GKevinLi/mouse/README.md

# Mouse: A custom wireless Bluetooth mouse




There is no cool name for it. I'm not good at naming things.

This is a wireless-capable Bluetooth mouse made entirely using custom parts. Everything required to make it is open source, and the files for each part are in their respective folders.
The only parts of this mouse that aren't custom are the battery and the various PCB attached components (switches, encoder, etc). 

This design can be used with any mouse switch, as long as it has dimensions of 12.8 x 5.8 x 6.5, and any 11mm mouse encoder. 6x6x7.3 silent switches theoretically should be able to work on this design as well, albeit with a few CAD modifications.

For more information on specific parts of the project, refer to the folder-specific READMEs in the cad, firmware, and pcb folders.\
CAD Readme: [Link](<https://github.com/GKevinLi/mouse/blob/main/cad/README.md>)\
Firmware Readme:  [Link](<https://github.com/GKevinLi/mouse/blob/main/firmware/README.md>)\
PCBs Readme:  [Link](<https://github.com/GKevinLi/mouse/blob/main/pcb/README.md>)

## Features

- PMW3610 Mouse Sensor
- nRF52833 Microcontroller
- Can be used when plugged in or on battery power
- Battery charging circuit
- Custom scroll wheel and mouse case
- 2 configurable side buttons

## Bill of Materials

| Item Name | Qty | Price (total) (USD) | Item link | Notes |
| --- | --- | --- | --- | --- |
| Mouse PCB, fully assembled | 2 | $150.05 | [Link](<https://jlcpcb.com/>) | this is how much it cost me for 5 PCBs, 2 fully assembled. Prices may vary. |
| PMW3610 | 1 | $1.09 | [Link](<https://www.aliexpress.us/item/3256809533648177.html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>) | this price is with the aliexpress welcome deal |
| Mouse Switch | 5 | $3.95 | [Link](<https://www.digikey.com/en/products/detail/aratas-formerly-omron-components-/D2FC-F-7N(60M)/20484328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>) | Any 12.8x5.8x6.5 mouse switch works, you can buy them or take them off old mice |
| 11mm Mouse Encoder | 1 | $9.39 | [Link](<https://www.amazon.com/dp/B07HCFMQ3X?plpRedirect=mhFallback&ref=clp_hp_h_pc>) | Any 11mm mouse encoder works, you can buy them or take them off old mice |
| 602535 Battery | 1 | $7.99 | [Link](<https://www.amazon.com/dp/B0GWCRMPSY?plpRedirect=mhFallback&ref=clp_hp_h_pc>) | Any 602535 battery works here. |
| **Total Price (USD)** | | **$172.47** | | |

To build the mouse fully, you will need a soldering iron (and some soldering experience), an SWD debugger, and access to a 3D printer. The links given in the BOM are just recommendations. The battery is optional and the mouse can be used via USB power without it.

## Building tips / Notes:
- This project is currently in a very early stage of development, so building this is not recommended at this time. Only try to build this yourself if you REALLY know what you are doing. It is possible that your project may not work due to some oversight I haven't found yet.
- I am a very busy college student so updates on this may be slow.
- There are probably many issues with this design that I have not discovered yet. Documented issues will be in the folder-specific READMEs.
- The current board design has several major issues. These will have to either be fixed in KiCad or by modifying the assembled board. A corrected version of the design will be made.... eventually, but for now I have documented the issues in the PCB folder's readme file.
- The current mouse case does not have side buttons. These will be added later as well.
- The current mouse case does not support mouse skates.
- To build this, you will have to order your own boards from JLCPCB or another PCB manufacturer. Instructions for this will not be provided at the moment, since the board design has issues anyway. If you have enough experience to fix them then you probably have enough experience to order the boards by yourself as well.
- There is currently not a lot of documentation on this project. This is just a fun personal project of mine at the moment, and I do not have that much time to consistently work on it. I will update this in the future, though.
- THIS IS NOT (currently) A GOOD MOUSE. Do not expect this project, in its current form, to be better than whatever mouse you personally own.

## Credits:
https://github.com/badjeff/leylabella for CAD references

https://github.com/siderakb/pmw3610-pcb for a PMW3610 schematic reference

https://github.com/wareya/DIY-Gaming-Mouse for PCB design and CAD references

KiCanvas PCB Link Here:
