GKevinLi/mouse/mouse_bom_2.csv

Item Name | Qty | Price (total) (USD) | Item link | Notes
Mouse PCB, fully assembled | 2 | $150.05 | https://jlcpcb.com/ | this is how much it cost me for 5 PCBs, 2 fully assembled. Prices may vary.
PMW3610 | 1 | $1.09 | https://www.aliexpress.us/item/3256809533648177.html?curPageLogUid=guoUMjTe3YSZ | this price is with the aliexpress welcome deal
Mouse Switch | 5 | $3.95 | https://www.digikey.com/en/products/detail/aratas-formerly-omron-components-/D2FC-F-7N(60M)/20484328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 | Any 12.8x5.8x6.5 mouse switch works, you can buy them or take them off old mice
11mm Mouse Encoder | 1 | $9.39 | https://www.amazon.com/dp/B07HCFMQ3X?plpRedirect=mhFallback&ref=clp_hp_h_pc | Any 11mm mouse encoder works, you can buy them or take them off old mice
602535 Battery | 1 | $7.99 | https://www.amazon.com/dp/B0GWCRMPSY?plpRedirect=mhFallback&ref=clp_hp_h_pc | Any 602535 battery works here.
Total Price (USD): | $172.47
