GKevinLi/mouse/pcb/production/bom.csv

Designator | Footprint | Quantity | Value | LCSC Part #
C1, C3 | 0402 | 2 | 10nf
C10, C16, C25, C26, C30, C31, C8, C9 | 0402 | 8 | 1uf
C11, C12, C19, C27, C28, C4, C5, C6 | 0402 | 8 | 100nf
C13, C14, C15 | 0603 | 3 | 4.7uf
C17 | 0402 | 1 | 47nf
C18 | 0402 | 1 | 820pf
C2, C33, C34 | 0603 | 3 | 10uf
C20 | 0402 | 1 | 100pf
C21 | 0402 | 1 | 1pf
C22 | 0402 | 1 | 1.2pf
C23, C24 | 0402 | 2 | 12pf
C32 | 0402 | 1 | 2.2uf
C7 | 0402 | 1 | 3.3uf
D4, D5 | 0603 | 2 | LED
IC2 | SOT8 | 1 | LM66200DRLR
J1 | USB_C_Receptacle_HCTL_HC-TYPE-C-16P-01A | 1 | USB_C_Receptacle_USB2.0_14P
J3 | JST_EH_B2B-EH-A_1x02_P2.50mm_Vertical | 1 | Screw_Terminal_01x02
L1 | 0603 | 1 | 10uH
L2 | 0402 | 1 | 15nH
L3 | 0402 | 1 | 4.7nH
L4 | 0402 | 1 | 2.2nH
Q1 | SOT95P280X145-6N | 1 | FS8205
R1, R29, R8 | 0402 | 3 | 10k
R10, R4, R9 | 0402 | 3 | 1k
R11 | 0402 | 1 | 5.1k
R3 | 0402 | 1 | 100
R5, R6 | 0402 | 2 | 5k1
SW1, SW2, SW4, SW6, SW7 | MOYUS SWITCXH | 5 | SW_SPDT_312
SW3 | MOUS WHEL | 1 | RotaryEncoder
SW5 | SW_JS102011JCQN | 1 | SW_SPDT
SW8 | SW_Push_SPST_NO_Alps_SKRK | 1 | SW_Push
TP1, TP10, TP11, TP12, TP13, TP14, TP2, TP3, TP4, TP5, TP6, TP7, TP8, TP9, VMAIN | TestPoint_Pad_D1.0mm | 15 | TestPoint
U1 | PMW3610DM-SUDU 16Pin | 1 | PMW3610
U2 | WSON-6-1EP_2x2mm_P0.65mm_EP1x1.6mm_ThermalVias | 1 | TLV76718DRVx
U4 | SOT-666 | 1 | USBLC6-2P6
U5 | SOT-23-6 | 1 | DW01A
U6 | SOIC-8-1EP_3.9x4.9mm_P1.27mm_EP2.41x3.3mm_ThermalVias | 1 | TP4056-42-ESOP8
U7 | SOT-23-3 | 1 | XC6206PxxxMR
U8 | QFN-40-1EP_5x5mm_P0.4mm_EP3.6x3.6mm | 1 | nRF52833_QDxx
Y2 | Crystal_SMD_2016-4Pin_2.0x1.6mm | 1 | Crystal_GND24
