GKevinLi/mouse/pcb/mous.step

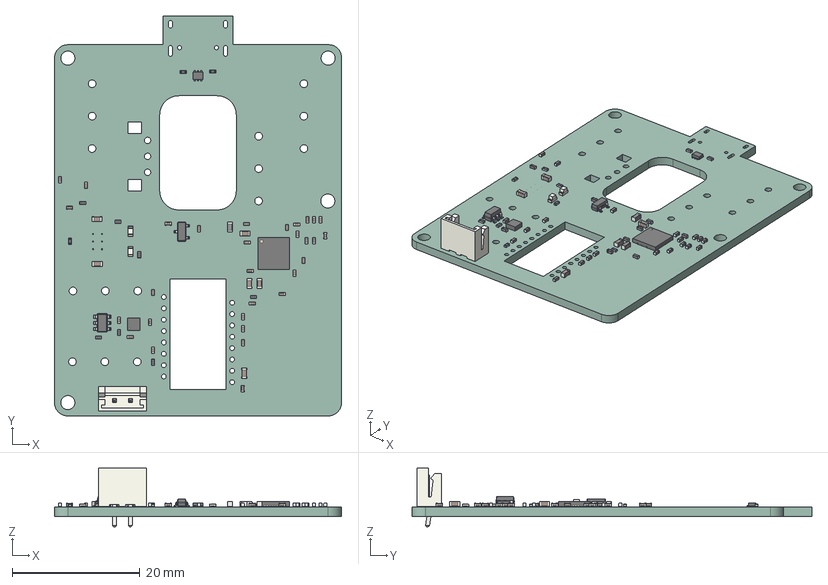
[picture p1: CAD file, 2026-10-29]
pcb/mous.step
45.0 x 62.7 x 9.20 mm
SOT-23-3
C_0402_1005Metric x 27
L_0603_1608Metric
LED_0603_1608Metric x 2
L_0402_1005Metric x 3
JST_EH_B2B-EH-A_1x02_P2.50mm_Vertical
R_0402_1005Metric x 10
C_0603_1608Metric x 6
WSON-6-1EP_2x2mm_P0.65mm_EP1x1.6mm
SOT-23-6
QFN-40-1EP_5x5mm_P0.4mm_EP3.6x3.6mm
SOT-666
mous_PCB
