GKevinLi/mouse/cad/mouse_top.step

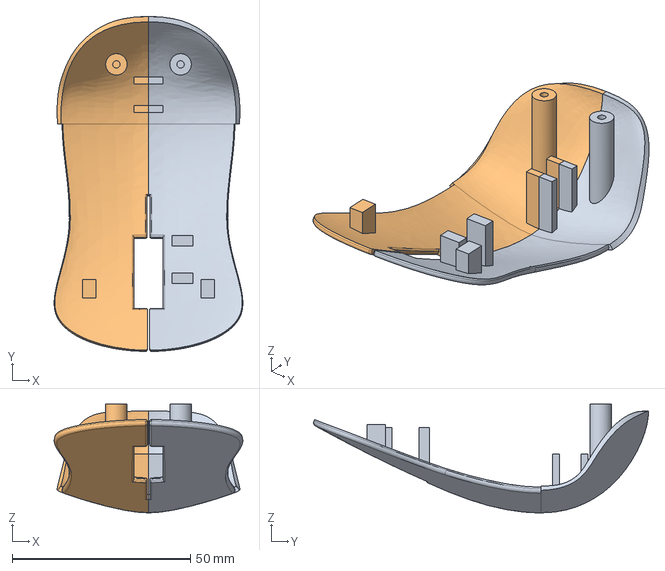
[picture p2: CAD file, 2026-10-29]
cad/mouse_top.step
52.9 x 93.9 x 30.5 mm
