GKevinLi/mouse/cad/mouse_bottom.step

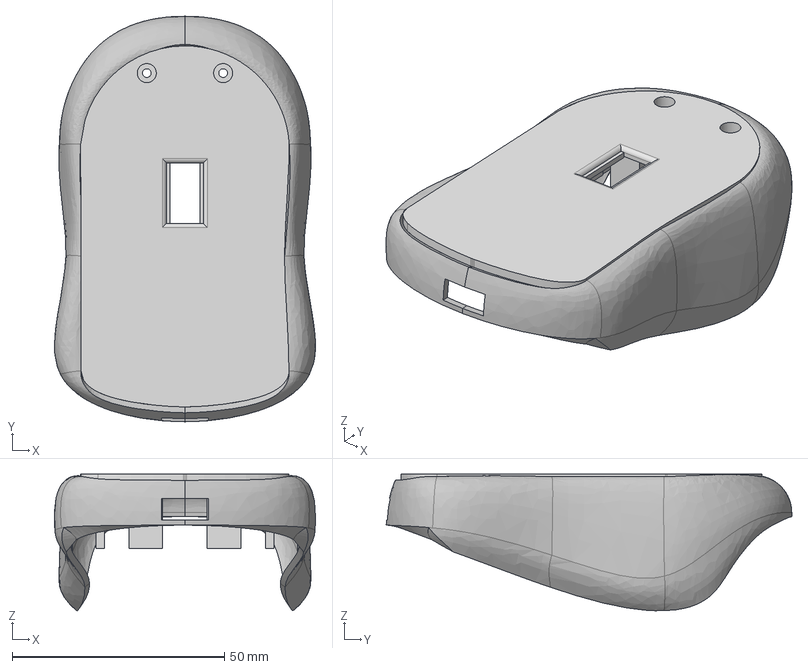
[picture p3: CAD file, 2026-10-29]
cad/mouse_bottom.step
61.5 x 95.6 x 32.2 mm
