GKevinLi/mouse/cad/scroll_wheel.step

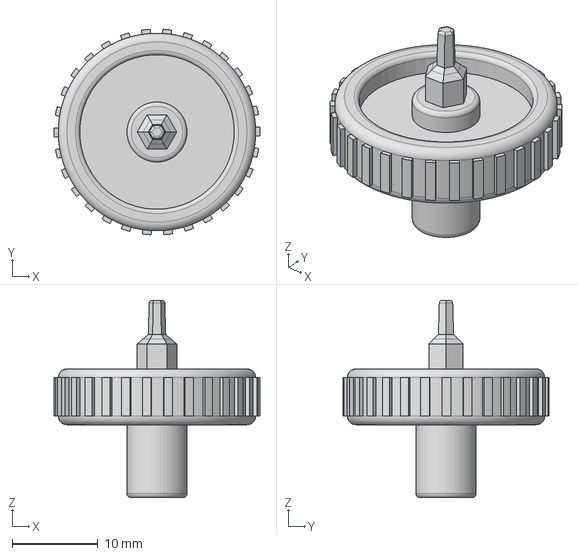
[picture p4: CAD file, 2026-10-29]
cad/scroll_wheel.step
24.0 x 24.0 x 23.0 mm
