GKevinLi/mouse/cad/screw_spacers.step

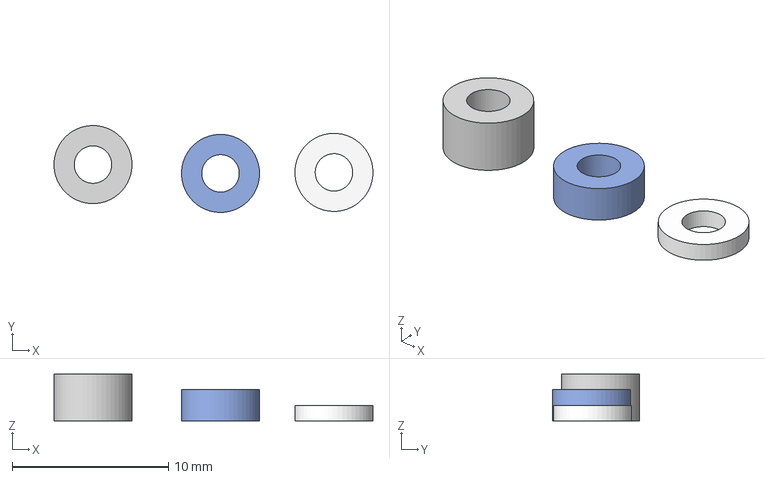
[picture p5: CAD file, 2026-10-29]
cad/screw_spacers.step
20.4 x 5.56 x 3.00 mm
