GKevinLi/mouse/pcb/mous.kicad_pcb

## KiCad design pcb/mous.kicad_pcb (2026-10-29)

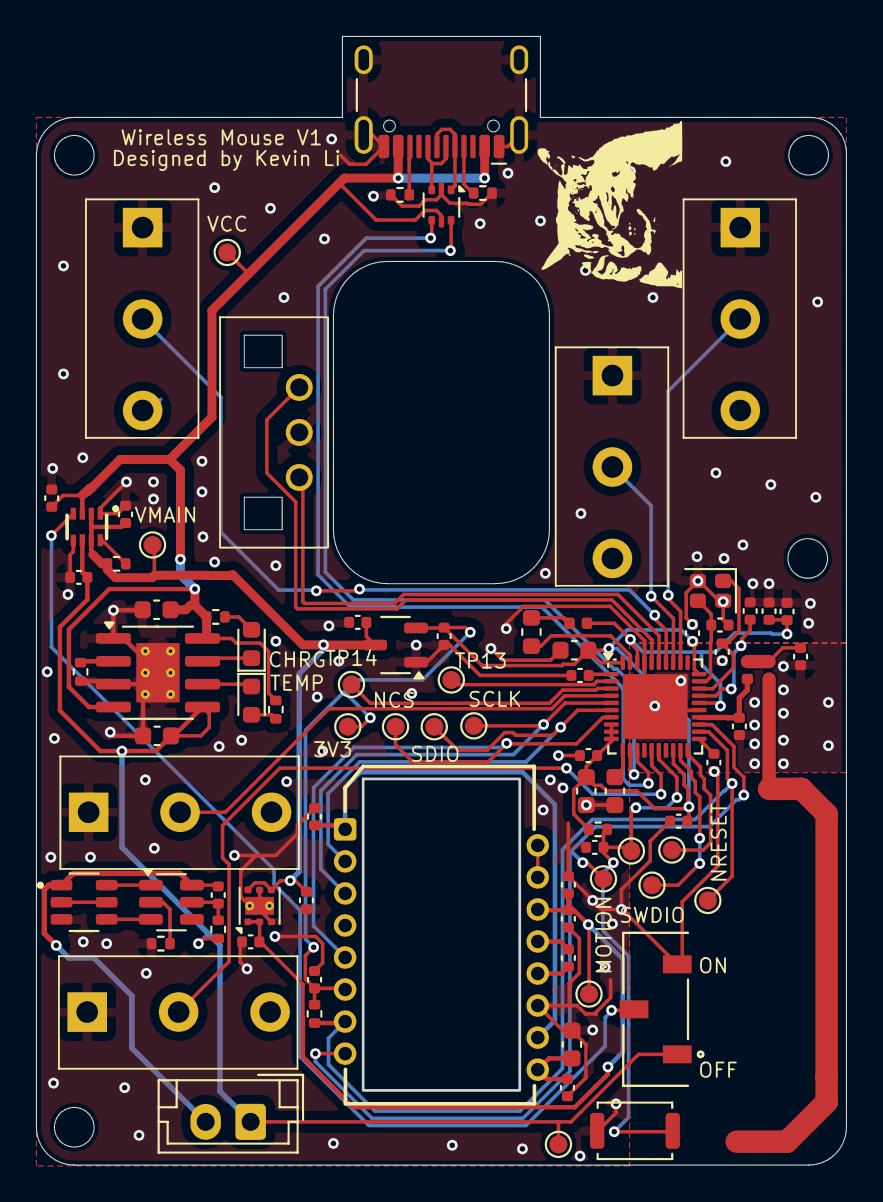
[picture p6: board mous.kicad_pcb from above]

Board: 4 copper layers, 45.0 x 62.7 mm, 84 parts (0 on the bottom side), 58 nets.

Parts:
C1, C3: 10nf; C_0402_1005Metric
C2, C33, C34: 10uf; C_0603_1608Metric
C4, C5, C6, C11, C12, C19, C27, C28: 100nf; C_0402_1005Metric
C7: 3.3uf; C_0402_1005Metric
C8, C9, C10, C16, C25, C26, C30, C31: 1uf; C_0402_1005Metric
C13, C14, C15: 4.7uf; C_0603_1608Metric
C17: 47nf; C_0402_1005Metric
C18: 820pf; C_0402_1005Metric
C20: 100pf; C_0402_1005Metric
C21: 1pf; C_0402_1005Metric
C22: 1.2pf; C_0402_1005Metric
C23, C24: 12pf; C_0402_1005Metric
C32: 2.2uf; C_0402_1005Metric
D4, D5: LED; LED_0603_1608Metric
IC2: LM66200DRLR; SOT8
J1: USB_C_Receptacle_USB2.0_14P; USB_C_Receptacle_HCTL_HC-TYPE-C-16P-01A
J3: Screw_Terminal_01x02; JST_EH_B2B-EH-A_1x02_P2.50mm_Vertical
L1: 10uH; L_0603_1608Metric
L2: 15nH; L_0402_1005Metric
L3: 4.7nH; L_0402_1005Metric
L4: 2.2nH; L_0402_1005Metric
Q1: FS8205; SOT95P280X145-6N
R1, R8, R29: 10k; R_0402_1005Metric
R3: 100; R_0402_1005Metric
R4, R9, R10: 1k; R_0402_1005Metric
R5, R6: 5k1; R_0402_1005Metric
R11: 5.1k; R_0402_1005Metric
SW1, SW2, SW4, SW6, SW7: SW_SPDT_312; MOYUS SWITCXH
SW3: RotaryEncoder; MOUS WHEL
SW5: SW_SPDT; SW_JS102011JCQN
SW8: SW_Push; SW_Push_SPST_NO_Alps_SKRK
TP1, TP2, TP3, TP4, TP5, TP6, TP7, TP8, TP9, TP10, TP11, TP12, TP13, TP14: TestPoint; TestPoint_Pad_D1.0mm
U1: PMW3610; PMW3610DM-SUDU 16Pin
U2: TLV76718DRVx; WSON-6-1EP_2x2mm_P0.65mm_EP1x1.6mm_ThermalVias
U4: USBLC6-2P6; SOT-666
U5: DW01A; SOT-23-6
U6: TP4056-42-ESOP8; SOIC-8-1EP_3.9x4.9mm_P1.27mm_EP2.41x3.3mm_ThermalVias
U7: XC6206PxxxMR; SOT-23-3
U8: nRF52833_QDxx; QFN-40-1EP_5x5mm_P0.4mm_EP3.6x3.6mm
VMAIN: TestPoint; TestPoint_Pad_D1.0mm
Y2: Crystal_GND24; Crystal_SMD_2016-4Pin_2.0x1.6mm

Connections:
+1V8: C6.1, C7.1, C9.1, TP12.1, U1.14 (VDD), U2.1 (OUT), U2.2 (SNS)
+3.3V: C5.1, C10.1, C11.1, C12.1, C13.1, C14.1, C26.1, R1.1, R29.2, TP11.1, U1.6 (VDDIO), U7.2 (VO), U8.8 (VDD), U8.9 (VDDH), U8.10 (VBUS), U8.18 (VDD), U8.30 (VDD), U8.40 (VDD)
BAT-: C27.2, J3.2, Q1.1, U5.6 (GND)
D+: U4.4 (I/O2), U8.13 (D+)
D-: U4.6 (I/O1), U8.12 (D-)
GND: C1.2, C2.2, C3.2, C5.2, C6.2, C7.2, C8.2, C9.2, C10.2, C11.2, C12.2, C13.2, C14.2, C15.2, C16.2, C17.2, C18.2, C19.2, C20.2, C21.2, C22.2, C23.2, C24.2, C25.2, C26.2, C28.2, C30.2, C31.2, C32.2, C33.2, C34.2, IC2.1 (GND@1), IC2.5 (GND@2), J1.A1 (GND), J1.A12 (GND), J1.B1 (GND), J1.B12 (GND), J1.S1 (SHIELD), Q1.3, R4.2, R5.2, R6.2, R11.2, SW1.1 (B), SW2.1 (B), SW3.C, SW4.1 (B), SW5.3 (C), SW6.1 (B), SW7.1 (B), SW8.1, U1.11 (GND), U2.3 (GND), U2.5 (GND), U2.7 (PAD), U4.2 (GND), U6.1 (TEMP), U6.3 (GND), U6.9 (EPAD), U7.1 (GND), U8.25 (VSS_PA), U8.37 (VSS), U8.41 (VSS), Y2.2, Y2.4
MOTION: TP7.1, U1.8 (MOTION), U8.23 (NFC2/P0.10)
MOUSE1: SW1.3 (A), U8.34 (AIN5/P0.29)
MOUSE2: SW2.3 (A), U8.32 (AIN0/P0.02)
MOUSE_MID: SW4.3 (A), U8.33 (AIN4/P0.28)
MOUSE_SIDE: SW6.3 (A), U8.4 (AIN2/P0.04)
MOUSE_SIDE_2: SW7.3 (A), U8.15 (P0.17)
NCS: TP6.1, U1.5 (NCS), U8.7 (P0.11)
NRESET: R1.2, TP8.1, U1.7 (NRESET), U8.22 (NFC1/P0.09)
unnamed: C22.1, L3.1, L4.2
unnamed: D4.2 (A), R9.2
unnamed: D4.1 (K), U6.6 (~STDBY)
unnamed: D5.2 (A), R10.2
unnamed: D5.1 (K), U6.7 (~CHRG)
unnamed: IC2.8 (ST), R8.2
unnamed: J1.A5 (CC1), R6.1
unnamed: J1.B5 (CC2), R5.1
unnamed: J1.A6 (D+), J1.B6 (D+), U4.3 (I/O2)
unnamed: J1.A7 (D-), J1.B7 (D-), U4.1 (I/O1)
unnamed: L1.1, L2.2
unnamed: Q1.2, Q1.5
unnamed: C3.1, U1.1 (+VCSEL), U1.10 (PASS_T)
unnamed: U1.15 (XYLASER), U1.16 (-VCSEL)
unnamed: C4.2, U1.13 (CN)
unnamed: C4.1, U1.12 (CP)
unnamed: C1.1, C2.1, U1.9 (VCP)
unnamed: R4.1, U5.2 (CS)
unnamed: Q1.4, U5.3 (OC)
unnamed: Q1.6, U5.1 (OD)
unnamed: C27.1, R3.2, U5.5 (VCC)
unnamed: R11.1, U6.2 (PROG)
unnamed: C21.1, L3.2, U8.24 (ANT)
unnamed: L1.2, U8.39 (DCC)
unnamed: C19.1, U8.1 (DEC1)
unnamed: C20.1, U8.27 (DEC3)
unnamed: C16.1, C17.1, L2.1, U8.26 (DEC6), U8.38 (DEC4)
unnamed: C18.1, U8.21 (DEC5)
unnamed: C15.1, U8.11 (DECUSB)
unnamed: C24.1, U8.28 (XC1), Y2.1
unnamed: C23.1, U8.29 (XC2), Y2.3
unnamed: TP13.1, U8.2 (XL1/P0.00)
unnamed: TP14.1, U8.3 (XL2/P0.01)
ON: IC2.4 (ON), SW5.2 (B)
P0.18: C28.1, R29.1, SW8.2, TP2.1, U8.16 (P0.18/~RESET)
SCLK: TP4.1, U1.3 (SCLK), U8.5 (AIN3/P0.05)
SCROLL_A: SW3.A, U8.36 (AIN7/P0.31)
SCROLL_B: SW3.B, U8.35 (AIN6/P0.30)
SDIO: TP5.1, U1.2 (SDIO), U8.6 (P1.09)
SWDCLK: TP3.1, U8.20 (SWDCLK)
SWDIO: TP1.1, U8.19 (SWDIO)
VBAT: C31.1, C34.1, IC2.6 (VIN2), J3.1, R3.1, SW5.1 (A), TP10.1, U6.5 (BAT)
VCC: C30.1, C33.1, IC2.3 (VIN1), J1.A4 (VBUS), J1.A9 (VBUS), J1.B4 (VBUS), J1.B9 (VBUS), R9.1, R10.1, TP9.1, U4.5 (VBUS), U6.4 (V_{CC}), U6.8 (CE)
V_MAIN: C8.1, C25.1, C32.1, IC2.2 (VOUT@1), IC2.7 (VOUT@2), R8.1, U2.4 (EN), U2.6 (IN), U7.3 (VI), VMAIN.1
