GKevinLi/mouse/(commit log)

2026-08-27 added code for sleeping / power management
2026-08-28 fixed devicetree problems
2026-08-29 side button cpi change
2026-10-29 add pcb and step files to repo
2026-10-29 added bom and readme
2026-10-29 added BOM to readme
2026-10-29 Add credits for CAD and schematic references
2026-10-29 Add DIY Gaming Mouse PCB design reference link
2026-10-29 Create README.md for Wireless Mouse CAD project
    Added README for Wireless Mouse CAD project with printing instructions and known issues.
2026-10-29 update bom and readme
2026-10-29 Update BOM
2026-10-29 Remove M2 Screws entry from mouse BOM
    Removed M2 Screws entry from the BOM.
2026-10-29 Update README with links to specific part READMEs
    Added links to folder-specific READMEs for CAD, firmware, and PCBs.
